Bourrasque-21/VGA_AIR_DRAWING/docs/async_fifo.png

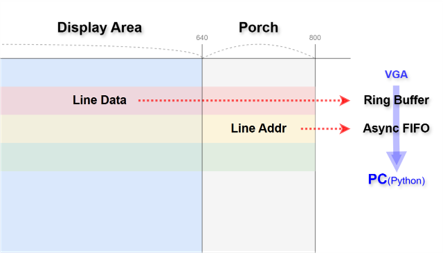
docs/async_fifo.png
