Bourrasque-21/VGA_AIR_DRAWING/docs/async_fifo_corrected.png

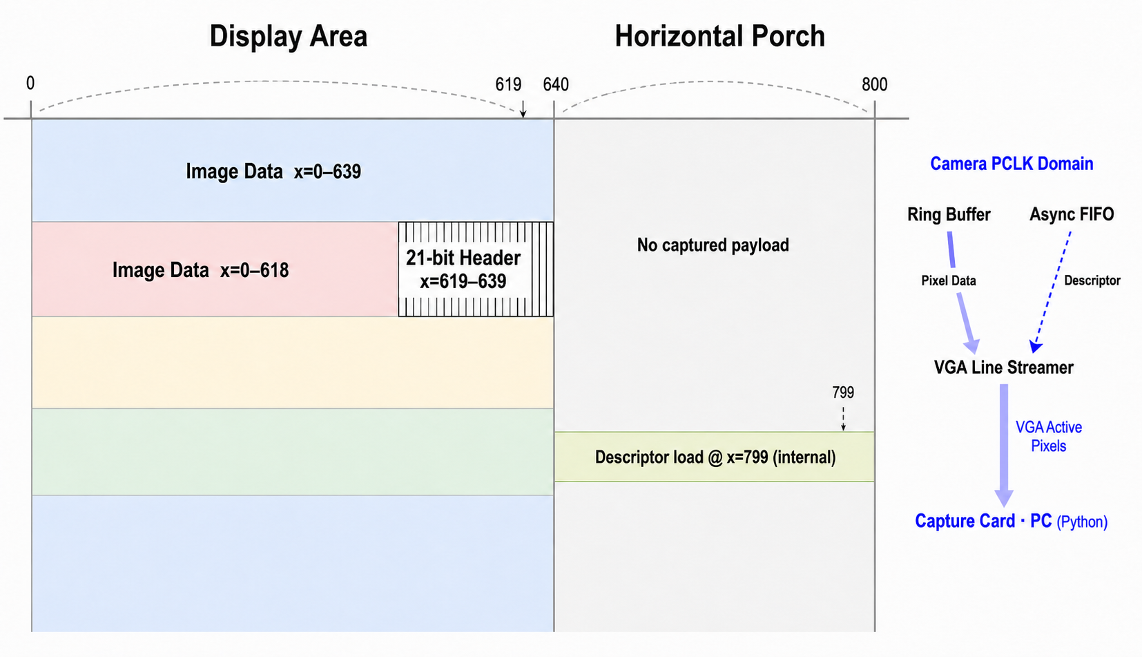
docs/async_fifo_corrected.png
