Bourrasque-21/VGA_AIR_DRAWING/docs/demo.jpg

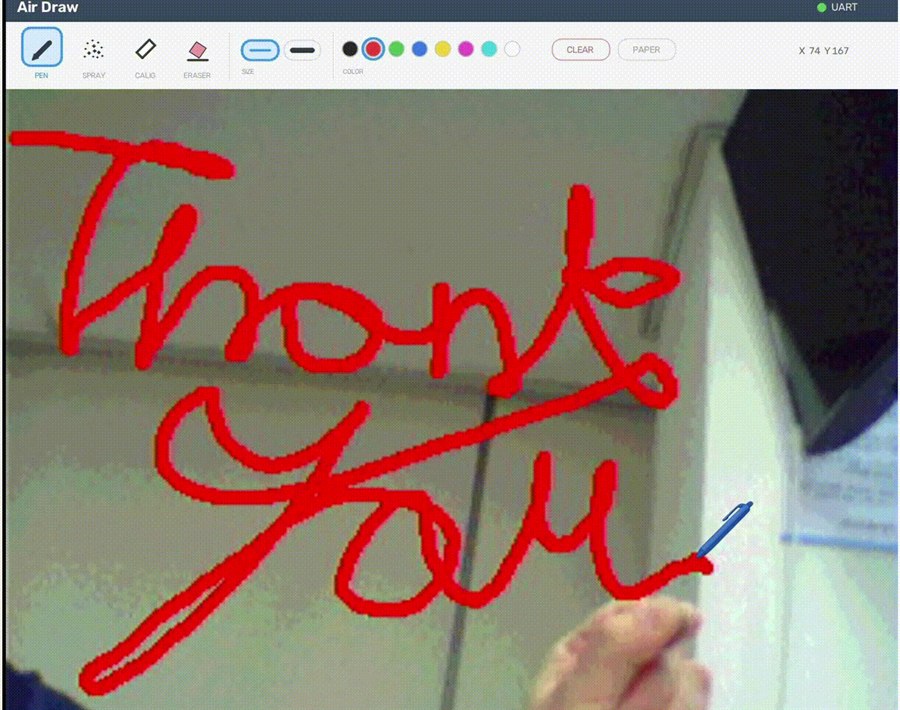
docs/demo.jpg
