Bourrasque-21/VGA_AIR_DRAWING/v1-framebuffer/python_ui/assets/marker_diag.png

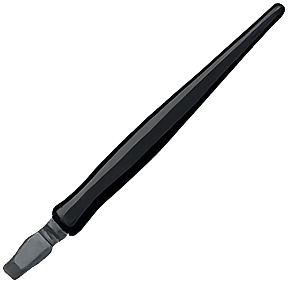
v1-framebuffer/python_ui/assets/marker_diag.png
