Bourrasque-21/VGA_AIR_DRAWING/v1-framebuffer/python_ui/assets/marker_spray.png

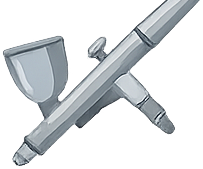
v1-framebuffer/python_ui/assets/marker_spray.png
