Bourrasque-21/VGA_AIR_DRAWING/v1-framebuffer/python_ui/tools_alpha.png

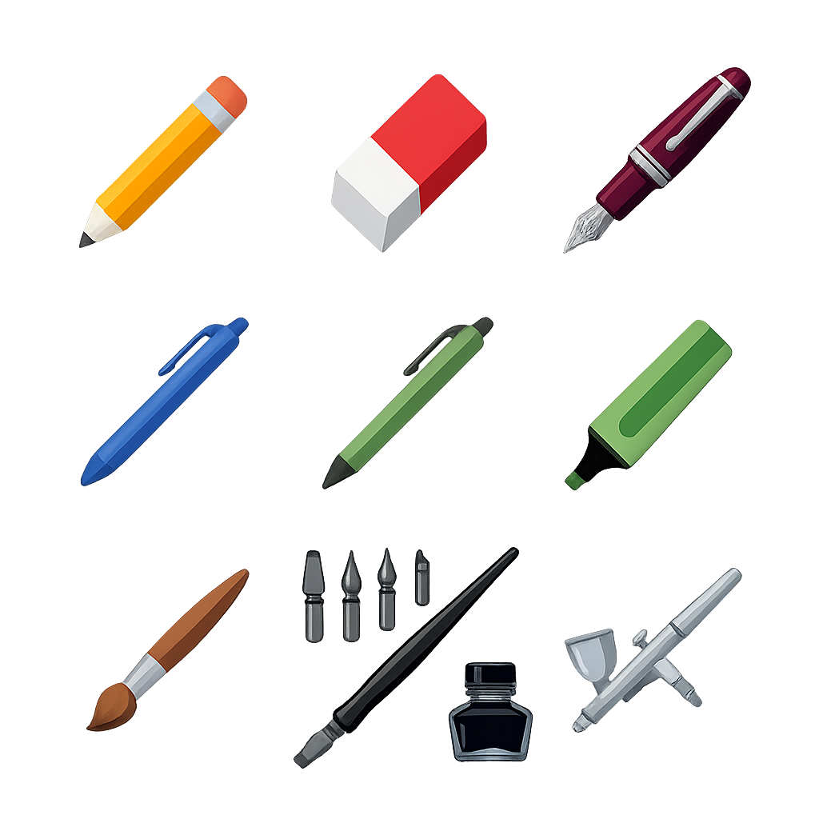
v1-framebuffer/python_ui/tools_alpha.png
