Bourrasque-21/VGA_AIR_DRAWING/v2-line-header/vga_uart_project/usage_statistics_webtalk.html

### Device Usage Page (usage_statistics_webtalk.html)

This HTML page displays the device usage statistics that will be sent to Xilinx.
To see the actual file transmitted to Xilinx, please click here.

software_version_and_target_device
beta | FALSE | build_version | 3064766
date_generated | Tue Jul 21 11:47:22 2026 | os_platform | WIN64
product_version | Vivado v2020.2 (64-bit) | project_id | ae6a24fd87c245fa87f675accf6b6b8f
project_iteration | 114 | random_id | de7f2466566f54a39cfa29d891cf61ec
registration_id | de7f2466566f54a39cfa29d891cf61ec | route_design | TRUE
target_device | xc7a35t | target_family | artix7
target_package | cpg236 | target_speed | -1
tool_flow | Vivado

user_environment
cpu_name | 12th Gen Intel(R) Core(TM) i7-1260P | cpu_speed | 2496 MHz
os_name | Windows Server 2016 or Windows 10 | os_release | major release (build 9200)
system_ram | 16.000 GB | total_processors | 1

vivado_usage

gui_handlers
basedialog_cancel=54 | basedialog_no=1 | basedialog_ok=110 | basedialog_yes=83
cfgmempartchooser_table=1 | cmdmsgdialog_messages=14 | cmdmsgdialog_ok=13 | expruntreepanel_exp_run_tree_table=2
filesetpanel_file_set_panel_tree=192 | flownavigatortreepanel_flow_navigator_tree=331 | hardwaretreepanel_hardware_tree_table=7 | hjfilechooserrecentlistpreview_recent_directories=19
logmonitor_monitor=14 | maintoolbarmgr_run=1 | msgtreepanel_message_view_tree=94 | msgview_critical_warnings=1
msgview_error_messages=2 | msgview_warning_messages=1 | netlistschematicview_show_io_ports_in_this_schematic=1 | numjobschooser_number_of_jobs=1
pacommandnames_add_config_memory=3 | pacommandnames_add_sources=11 | pacommandnames_auto_connect_target=27 | pacommandnames_create_hardware_dashboards=2
pacommandnames_goto_implemented_design=1 | pacommandnames_new_hardware_dashboard=1 | pacommandnames_open_hardware_manager=10 | pacommandnames_run_bitgen=86
pacommandnames_synth_settings=1 | pacommandnames_zoom_fit=1 | paviews_device=1 | paviews_project_summary=70
programfpgadialog_program=140 | programfpgadialog_specify_bitstream_file=64 | projectsummaryutilizationgadget_project_summary_utilization_gadget_tabbed=40 | projectsummaryutilizationpanel_project_summary_utilization_panel_tabbed=98
projectsummaryutilizationpanel_project_summary_utilization_table=37 | projecttab_reload=14 | rdicommands_delete=5 | rungadget_show_error_and_critical_warning_messages=2
rungadget_show_warning_and_error_messages_in_messages=3 | settingsdialog_project_tree=1 | srcchooserpanel_add_directories=1 | srcchooserpanel_add_hdl_and_netlist_files_to_your_project=11
stalerundialog_no=1 | statemonitor_reset_step=4 | syntheticastatemonitor_cancel=4 | tclconsoleview_tcl_console_code_editor=9

java_command_handlers
addcfgmem=3 | addsources=12 | autoconnecttarget=27 | createhardwaredashboards=2
editdelete=5 | exitapp=26 | launchprogramfpga=148 | newhardwaredashboard=1
openhardwaremanager=187 | openrecenttarget=31 | programdevice=158 | runbitgen=87
runimplementation=1 | runschematic=9 | runsynthesis=1 | showview=6
toolssettings=2 | viewtaskimplementation=2 | viewtaskprojectmanager=59 | zoomfit=1

other_data
batchmode=62 | guimode=29 | tclmode=12

project_data
constraintsetcount=1 | core_container=false | currentimplrun=impl_1 | currentsynthesisrun=synth_1
default_library=xil_defaultlib | designmode=RTL | export_simulation_activehdl=4 | export_simulation_ies=4
export_simulation_modelsim=4 | export_simulation_questa=4 | export_simulation_riviera=4 | export_simulation_vcs=4
export_simulation_xsim=4 | implstrategy=Vivado Implementation Defaults | launch_simulation_activehdl=0 | launch_simulation_ies=0
launch_simulation_modelsim=0 | launch_simulation_questa=0 | launch_simulation_riviera=0 | launch_simulation_vcs=0
launch_simulation_xsim=0 | simulator_language=Mixed | srcsetcount=41 | synthesisstrategy=Vivado Synthesis Defaults
target_language=Verilog | target_simulator=XSim | totalimplruns=1 | totalsynthesisruns=1

unisim_transformation

post_unisim_transformation
bufg=4 | carry4=227 | dsp48e1=5 | fdce=668
fdpe=33 | fdre=610 | gnd=27 | ibuf=19
lut1=80 | lut2=397 | lut3=298 | lut4=413
lut5=248 | lut6=398 | mmcme2_adv=1 | muxf7=10
obuf=17 | obuft=1 | ramb36e1=36 | ramd64e=28

vcc=32

pre_unisim_transformation
bufg=4 | carry4=227 | dsp48e1=5 | fdce=668
fdpe=33 | fdre=610 | gnd=23 | ibuf=19
lut1=80 | lut2=397 | lut3=298 | lut4=413
lut5=248 | lut6=398 | mmcme2_base=1 | muxf7=10
obuf=17 | obuft=1 | ram64m=7 | ramb36e1=36

vcc=30

power_opt_design

command_line_options_spo
-cell_types=default::all | -clocks=default::[not_specified] | -exclude_cells=default::[not_specified] | -include_cells=default::[not_specified]

usage
bram_ports_augmented=20 | bram_ports_newly_gated=20 | bram_ports_total=72 | flow_state=default
slice_registers_augmented=0 | slice_registers_newly_gated=0 | slice_registers_total=1311 | srls_augmented=0
srls_newly_gated=0 | srls_total=0

ip_statistics

xpm_memory_base/1
addr_width_a=16 | addr_width_b=16 | auto_sleep_time=0 | byte_write_width_a=12
byte_write_width_b=12 | cascade_height=0 | clocking_mode=1 | core_container=NA
ecc_mode=0 | iptotal=1 | max_num_char=0 | memory_init_param=0
memory_optimization=true | memory_primitive=2 | memory_size=491520 | memory_type=2
message_control=0 | num_char_loc=0 | p_ecc_mode=no_ecc | p_enable_byte_write_a=0
p_enable_byte_write_b=0 | p_max_depth_data=40960 | p_memory_opt=yes | p_memory_primitive=block
p_min_width_data=12 | p_min_width_data_a=12 | p_min_width_data_b=12 | p_min_width_data_ecc=12
p_min_width_data_ldw=4 | p_min_width_data_shft=12 | p_num_cols_write_a=1 | p_num_cols_write_b=1
p_num_rows_read_a=1 | p_num_rows_read_b=1 | p_num_rows_write_a=1 | p_num_rows_write_b=1
p_sdp_write_mode=yes | p_width_addr_lsb_read_a=0 | p_width_addr_lsb_read_b=0 | p_width_addr_lsb_write_a=0
p_width_addr_lsb_write_b=0 | p_width_addr_read_a=16 | p_width_addr_read_b=16 | p_width_addr_write_a=16
p_width_addr_write_b=16 | p_width_col_write_a=12 | p_width_col_write_b=12 | read_data_width_a=12
read_data_width_b=12 | read_latency_a=1 | read_latency_b=1 | read_reset_value_a=0
read_reset_value_b=0 | rst_mode_a=SYNC | rst_mode_b=SYNC | rsta_loop_iter=12
rstb_loop_iter=12 | sim_assert_chk=0 | use_embedded_constraint=0 | use_mem_init=0
use_mem_init_mmi=0 | version=0 | wakeup_time=0 | write_data_width_a=12
write_data_width_b=12 | write_mode_a=2 | write_mode_b=1 | write_protect=1

synthesis

command_line_options
-assert=default::[not_specified] | -bufg=default::12 | -cascade_dsp=default::auto | -constrset=default::[not_specified]
-control_set_opt_threshold=default::auto | -debug_log=default::[not_specified] | -directive=default::default | -fanout_limit=default::10000
-flatten_hierarchy=default::rebuilt | -fsm_extraction=default::auto | -gated_clock_conversion=default::off | -generic=default::[not_specified]
-include_dirs=default::[not_specified] | -keep_equivalent_registers=default::[not_specified] | -lint=default::[not_specified] | -max_bram=default::-1
-max_bram_cascade_height=default::-1 | -max_dsp=default::-1 | -max_uram=default::-1 | -max_uram_cascade_height=default::-1
-mode=default::default | -name=default::[not_specified] | -no_lc=default::[not_specified] | -no_srlextract=default::[not_specified]
-no_timing_driven=default::[not_specified] | -os=default::[not_specified] | -part=xc7a35tcpg236-1 | -resource_sharing=default::auto
-retiming=default::[not_specified] | -rtl=default::[not_specified] | -rtl_skip_constraints=default::[not_specified] | -rtl_skip_ip=default::[not_specified]
-seu_protect=default::none | -sfcu=default::[not_specified] | -shreg_min_size=default::3 | -top=top_airDrawing

-verilog_define=default::[not_specified]

usage
elapsed=00:01:00s | hls_ip=0 | memory_gain=237.562MB | memory_peak=1355.633MB
