Bourrasque-21/VGA_AIR_DRAWING/v1-framebuffer/vga_uart_project/vga_uart_project.srcs/sources_1/overlay_pixel_mux.sv

module overlay_pixel_mux (
    input  logic        i_canvas_valid,
    input  logic [15:0] i_frame_pixel,
    input  logic [15:0] i_canvas_pixel,
    output logic [15:0] o_display_pixel
);
    assign o_display_pixel = i_canvas_valid ? i_canvas_pixel : i_frame_pixel;
endmodule
