Bourrasque-21/VGA_AIR_DRAWING/(commit log)

2026-08-10 docs: add root README with v1/v2 architecture comparison
    - 링버퍼 구조(640x64 RGB444), VGA 전송 화면 A/B, 21컬럼 라인 헤더 설명
    - v1/v2 BRAM 사용량 비교 (320x240 96% -> 36%, 640x480 72%)
    - UVM 검증 결과표 9개 모듈 커버리지 100%
    - 마커 추적 6단계와 센트로이드 채택 근거
    - 해상도 비교 이미지 2장 추가
2026-08-10 docs: add demo capture and architecture diagrams to README
    - 데모 이미지: 허공에 쓴 "Thank You" (발표 영상 캡처)
    - 통합 시스템 구조도 추가, 데이터 경로 분기 설명 보강
    - 풀 프레임버퍼 vs 64라인 링버퍼 비교 도표 추가
2026-08-24 docs: add staged drawing result animations
2026-08-26 assets: tighten project banner spacing
2026-08-27 docs: link 128-line prototype design
2026-09-03 docs: explain v2 evolution from 128-line prototype
